ashwin-chandra-r/DN-lab-Project/Sallen-Key_HPF_Channel2_TB.asc

C1: cap; 10n
C2: cap; 10n
Cblk: polcap; 1u
Cdec1: polcap; 100u
Cdec2: cap; 100n
Cin: polcap; 1u
Cout: polcap; 10u
M1: nmos; 2N7000
R1: res; 10k
R2: res; 22k
Rbias1: res; 1Meg
Rbias2: res; 1Meg
Rbleed: res; 100k
RS: res; 1.68k
Rstop: res; 1k
V1: voltage; 9
V2: voltage; SINE(0 0.5 {f}) AC 1
Named nets: 0, IN, VCC, OUT, gate, source
Channel 2: Sallen-Key high-pass filter (tweeter)  -  2N7000 source follower, fc = 1.07 kHz
+9 V supply and decoupling (Table 1)
TESTBENCH: Channel 2 high-pass - 1 Vpp sine stepped over the Table 3 frequencies. Results: View > SPICE Error Log (steps 1-9 = 50, 100, 200, 500, 1k, 1070, 2k, 5k, 10k Hz)
.param f=1k
Test 1 (active): Table 2 DC voltages and Table 3 Vpp / gain
.step param f list 50 100 200 500 1k 1070 2k 5k 10k
.tran 0 {0.2+10/f} 0.2 {1/(200*f)}
.meas TRAN Vin_pp PP V(in)
.meas TRAN Vout_pp PP V(out)
.meas TRAN Gain PARAM Vout_pp/Vin_pp
.meas TRAN V_gate AVG V(gate)
.meas TRAN V_source AVG V(source)
.meas TRAN V_rail_to_gate AVG V(VCC)-V(gate)
Test 2 (Bode plot / cutoff): right-click each block, swap Comment <-> SPICE directive
.ac dec 100 10 100k
.meas AC G_pass MAX mag(V(out))
.meas AC f_3dB WHEN mag(V(out))=G_pass/sqrt(2)
.meas AC G_1070 FIND mag(V(out)) AT 1070
.meas AC Ph_1070 FIND ph(V(out)) AT 1070
