ashwin-chandra-r/DN-lab-Project/Sallen-Key_LPF_Channel1.asc

C1: cap; 22n
C2: cap; 10n
Cin: polcap; 1µ
Cout: polcap; 10µ
M1: nmos; 2N7000
R1: res; 10k
R2: res; 10k
Rbias1: res; 1Meg
Rbias2: res; 1Meg
Rbleed: res; 100k
RS: res; 1.68k
Rstop: res; 1k
V2: voltage; SINE(0 0.5 1k) AC 1
Named nets: 0, IN, VCC, OUT
Channel 1: Sallen-Key low-pass filter (woofer)  -  2N7000 source follower, fc = 1.07 kHz
